SINRG-Lab/AIGlasses/mechanical/README.md

# Mechanical (3D-printed frame)

| Folder | Contents |
|---|---|
| `v3/` | Current parts: right arm, arm cover, hinge system (STL) |
| `hero-renders/` | Exploded view + renders |
| `older/v1`, `older/v2` | Earlier frame revisions (STL/3MF/F3D, presentation) |
| `older/design-1`, `older/design-2`, `older/vision` | Early concept iterations (Mar–May 2026) |

Sliced printer files (`.ufp`, `.bgcode`, `.gcode`) are not kept — slice the STL/3MF for your printer.
