SINRG-Lab/AIGlasses/companion/hardware/pcb/README.md

# PCB

| Path | Contents |
|---|---|
| `schematic/AIglasses.kicad_sch` | KiCad schematic |
| `schematic/Smart_Glasses_V1.pdf` | V1 schematic export |
| `v2-right/gerbers/` | KiCad Gerbers + drill for `Smart_Glasses_V2_PCB_RIGHT` (the right-temple board), plus the JLCPCB upload previews/metadata |
| `v2-right/jlc-production/` | JLCPCB's processed production data for order `12041108A_Y5` (ODB++ and per-layer files) |

No LEFT-board fab files are in the repo.
