SINRG-Lab/AIGlasses/Cad Designs/Older/V1/Presentation1.pptx

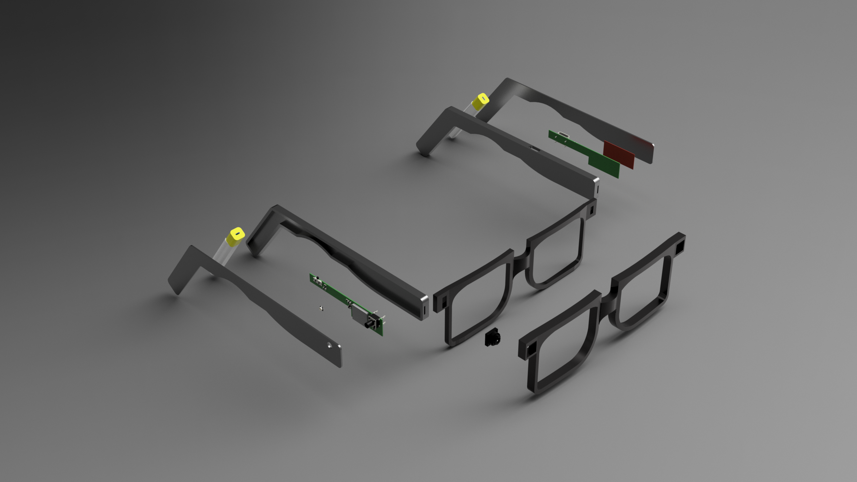
[picture p23: figure]

Right & Left Arms

Batteries

Arm Covers

Custom PCB’S

Antenna

Programmable touchpad

Frame Covers

Camera

Frames
