SINRG-Lab/AIGlasses/Cad Designs/V3/AmrHInges3/Metadata/thumbnail.png

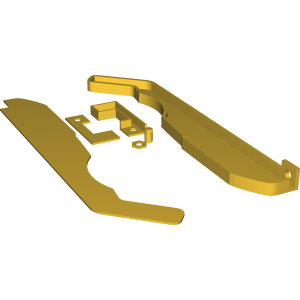
Cad Designs/V3/AmrHInges3/Metadata/thumbnail.png
