SINRG-Lab/AIGlasses/companion/hardware/pcb/v2-right/gerbers/GBR_11290166_1_bottom.png

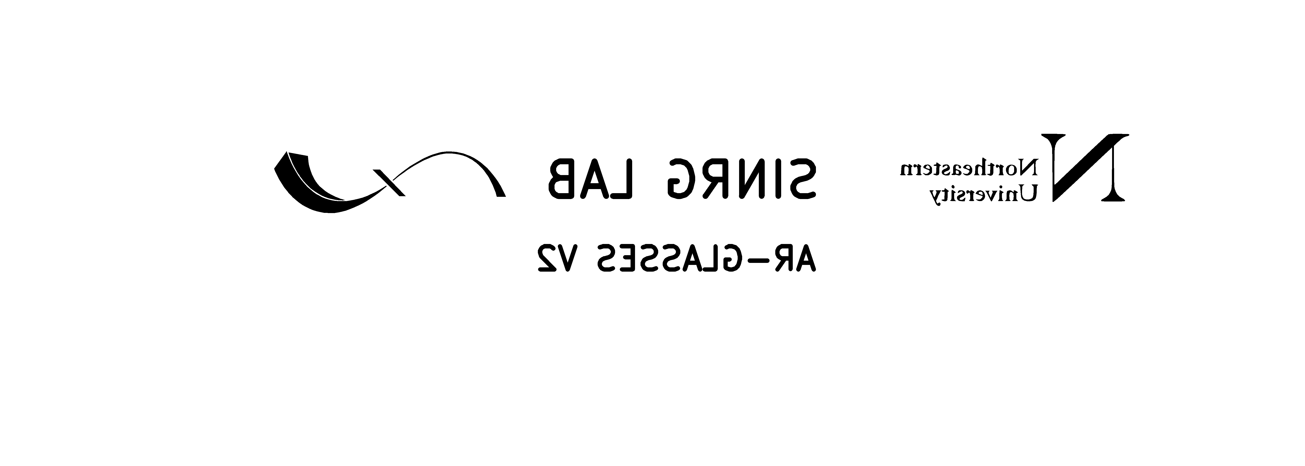
companion/hardware/pcb/v2-right/gerbers/GBR_11290166_1_bottom.png
