SINRG-Lab/AIGlasses/mechanical/hero-renders/Screenshot 2026-05-05 at 3.59.41 PM.png

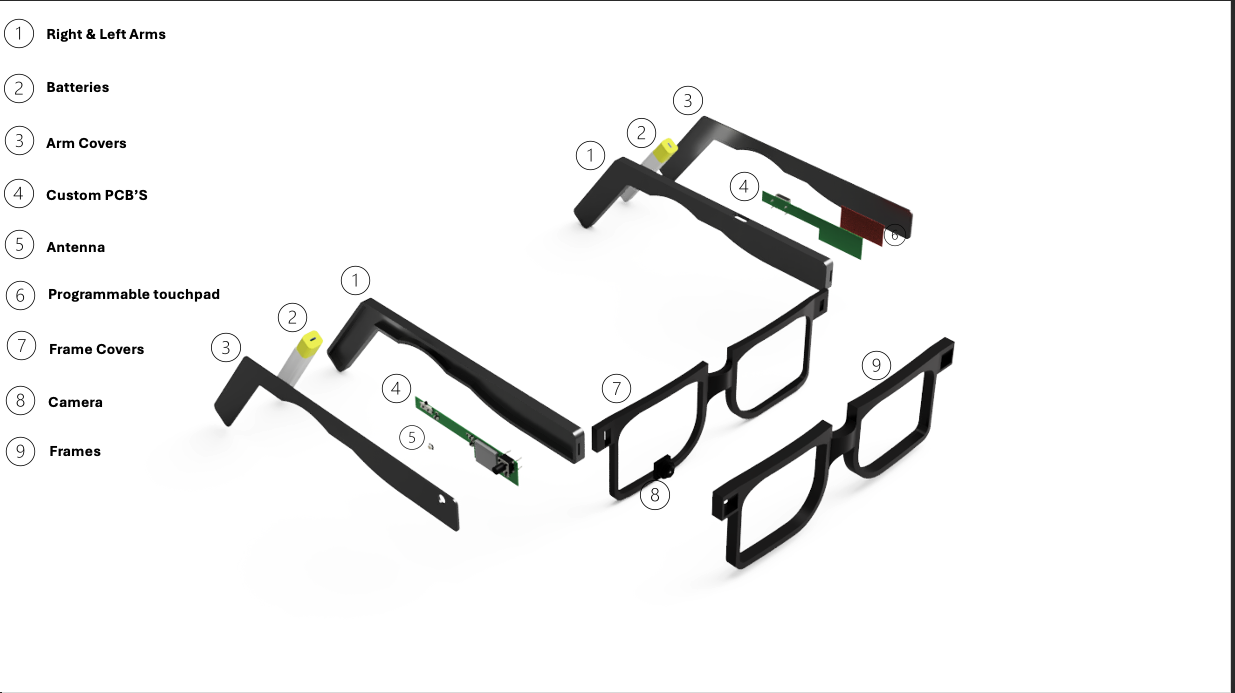
mechanical/hero-renders/Screenshot 2026-05-05 at 3.59.41 PM.png
