SINRG-Lab/AIGlasses/Cad Designs/V3/STL/HingeTop(T).stl

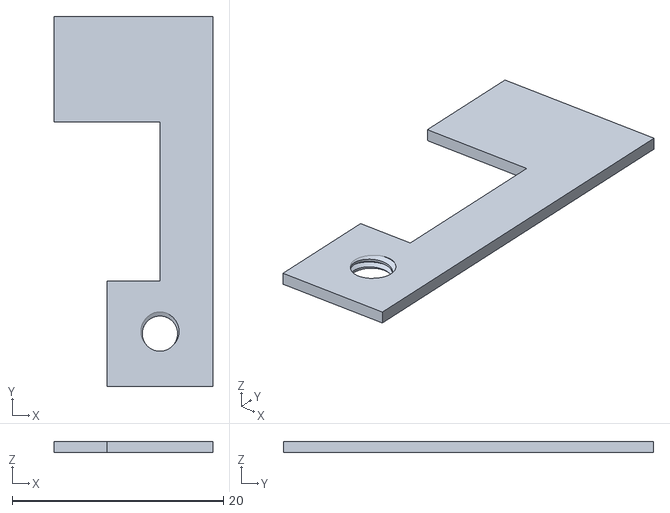
[picture p30: CAD file, 2026-06-15]
Cad Designs/V3/STL/HingeTop(T).stl
15.0 x 35.0 x 1.00
