SINRG-Lab/AIGlasses/mechanical/v3/HIngeTop v2.stl

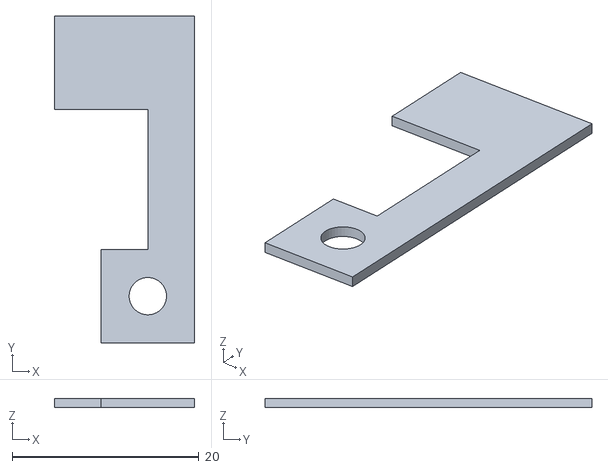
[picture p32: CAD file, 2026-10-23]
mechanical/v3/HIngeTop v2.stl
15.0 x 35.0 x 1.00
