SINRG-Lab/AIGlasses/mechanical/v3/Rod v6.stl

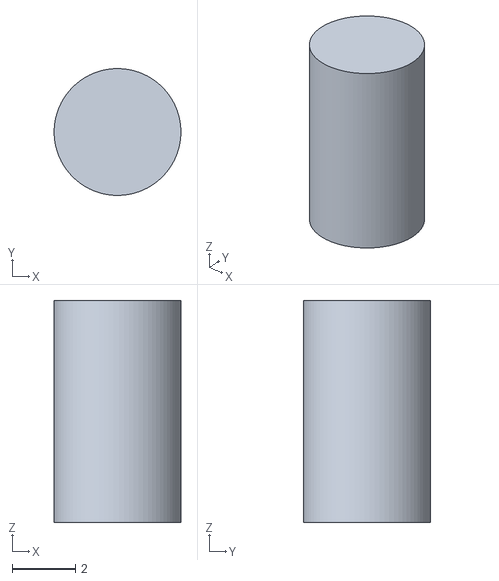
[picture p34: CAD file, 2026-10-23]
mechanical/v3/Rod v6.stl
4.00 x 4.00 x 7.00
