SINRG-Lab/AIGlasses/mechanical/v3/ArmCover.stl

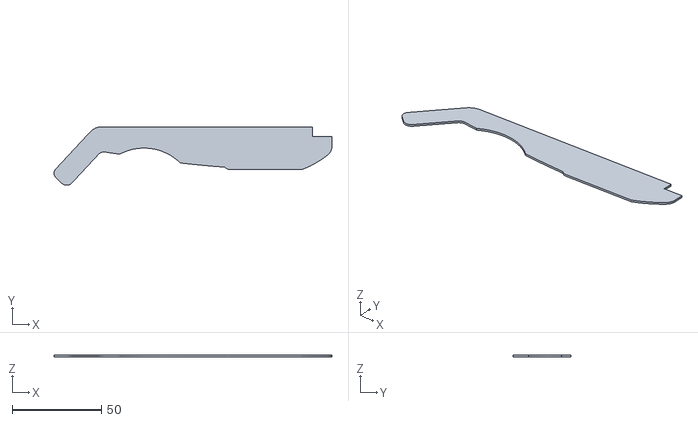
[picture p35: CAD file, 2026-10-23]
mechanical/v3/ArmCover.stl
155.8 x 32.8 x 1.00
