SINRG-Lab/AIGlasses/mechanical/v3/ThreadedRod.stl

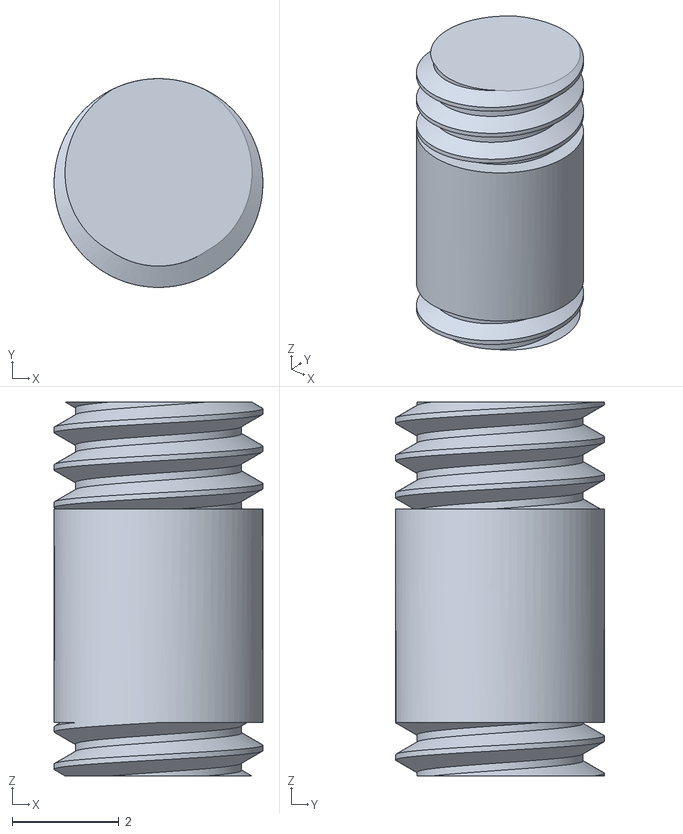
[picture p36: CAD file, 2026-10-23]
mechanical/v3/ThreadedRod.stl
3.91 x 3.91 x 7.00
