SINRG-Lab/AIGlasses/mechanical/v3/Hinge v2.stl

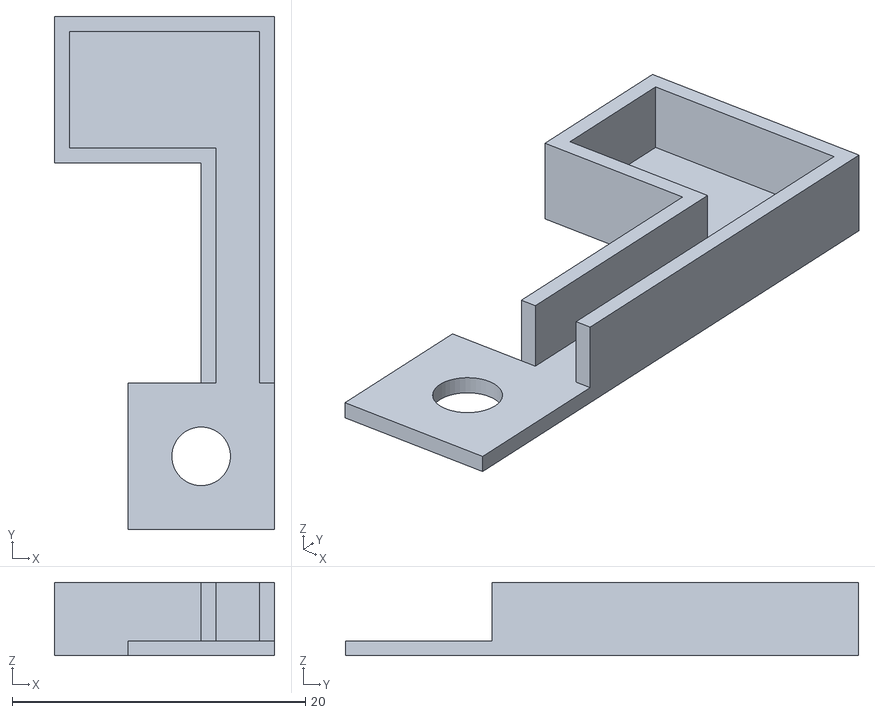
[picture p37: CAD file, 2026-10-23]
mechanical/v3/Hinge v2.stl
15.0 x 35.0 x 5.00
