SINRG-Lab/AIGlasses/mechanical/v3/Nut.stl

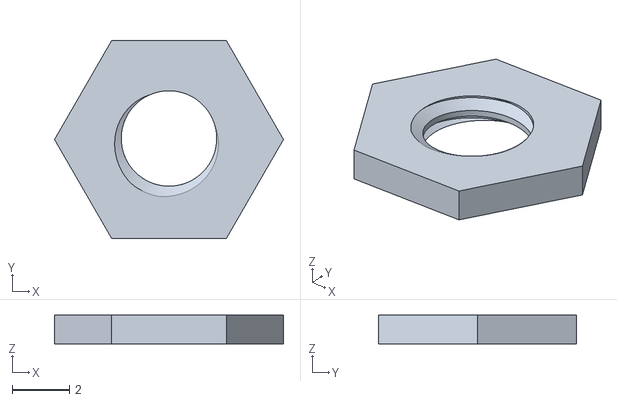
[picture p38: CAD file, 2026-10-23]
mechanical/v3/Nut.stl
8.00 x 6.93 x 1.00
