SINRG-Lab/AIGlasses/Cad Designs/Older/Glasses 3D Design 1/Arm1.stl

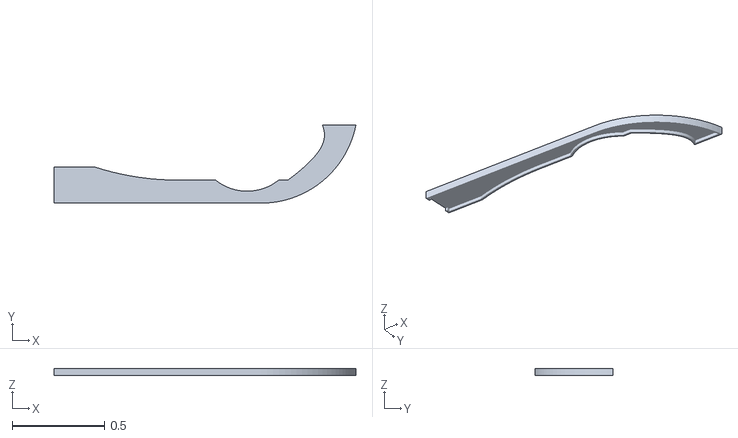
[picture p39: CAD file, 2026-06-15, an earlier design]
Cad Designs/Older/Glasses 3D Design 1/Arm1.stl
1.64 x 0.425 x 0.04
