SINRG-Lab/AIGlasses/Cad Designs/Older/Glasses 3d Design 2/ArmRight2.stl

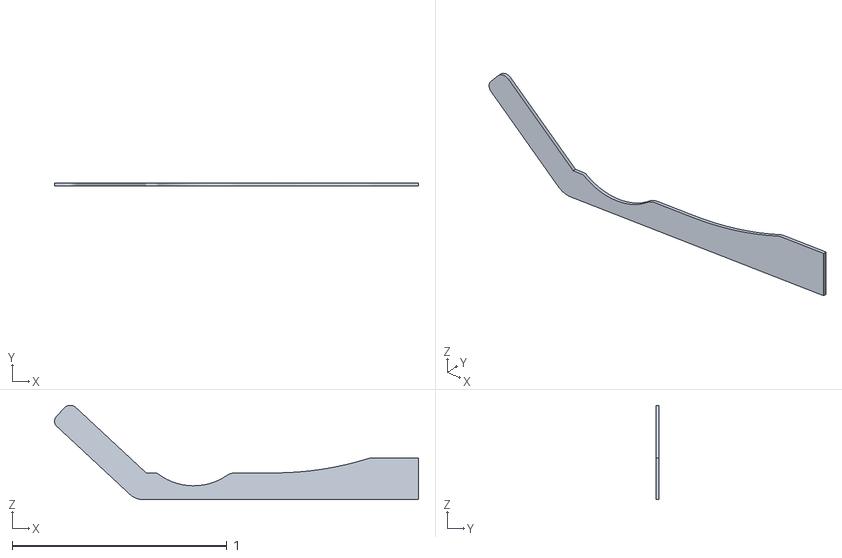
[picture p40: CAD file, 2026-06-15, an earlier design]
Cad Designs/Older/Glasses 3d Design 2/ArmRight2.stl
1.70 x 0.015 x 0.44
