SINRG-Lab/AIGlasses/Cad Designs/Older/V1/RightArm v1.stl

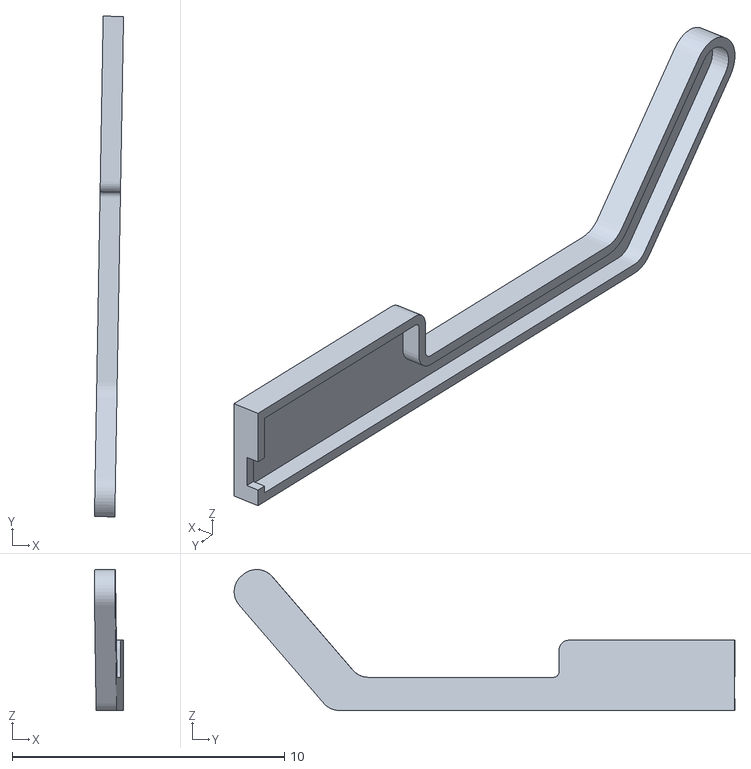
[picture p41: CAD file, 2026-06-15, an earlier design]
Cad Designs/Older/V1/RightArm v1.stl
1.07 x 18.4 x 5.18
