SINRG-Lab/AIGlasses/Cad Designs/Older/V2/STL/LeftCover v1.stl

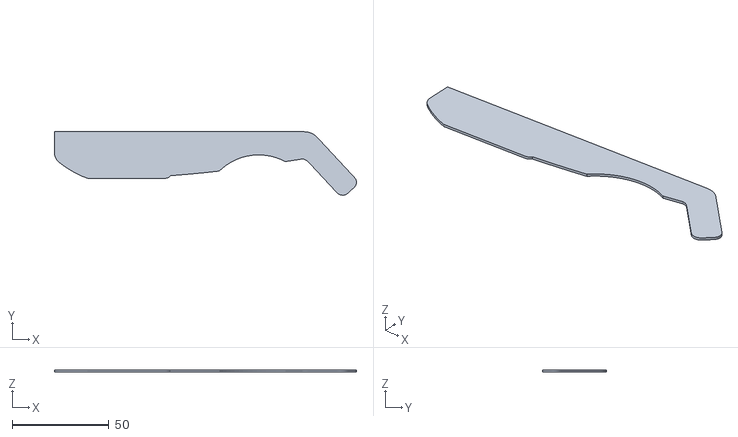
[picture p43: CAD file, 2026-06-15, an earlier design]
Cad Designs/Older/V2/STL/LeftCover v1.stl
155.8 x 32.8 x 1.00
