SINRG-Lab/AIGlasses/mechanical/older/design-2/Glasses.3mf

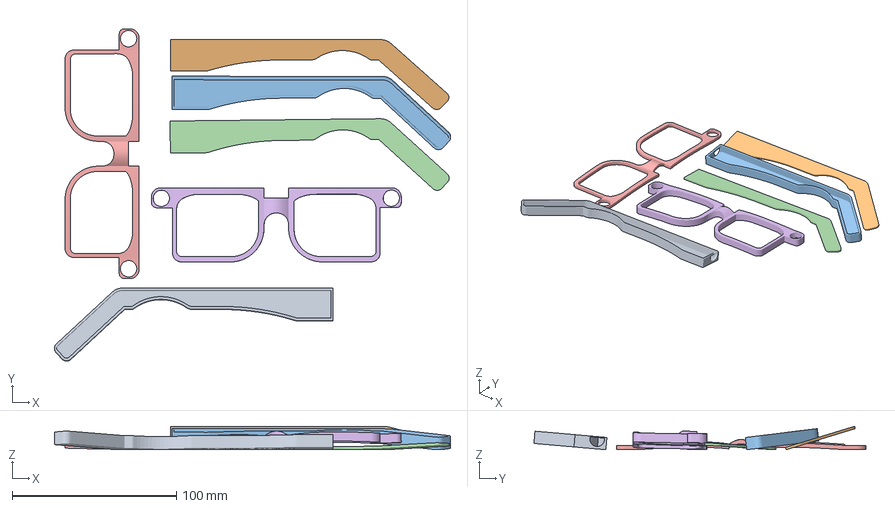
[picture p44: CAD file, 2026-10-23, an earlier design]
mechanical/older/design-2/Glasses.3mf
241.0 x 202.2 x 14.3 mm
ArmLeft1.stl
ArmLeft2.stl
ArmRight1.stl
ArmRight2.stl
Front2.stl
Front.stl
