SINRG-Lab/AIGlasses/mechanical/older/v1/LeftArm v1.stl

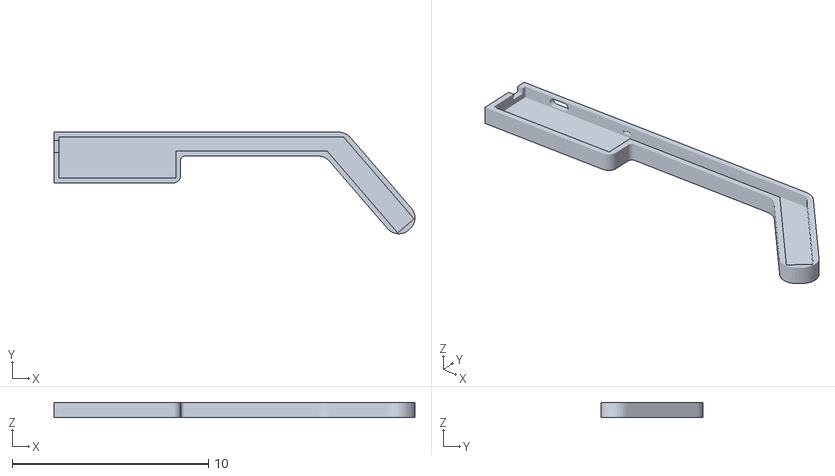
[picture p45: CAD file, 2026-10-23, an earlier design]
mechanical/older/v1/LeftArm v1.stl
18.4 x 5.18 x 0.75
