SINRG-Lab/AIGlasses/mechanical/older/v2/STL/Body1.stl

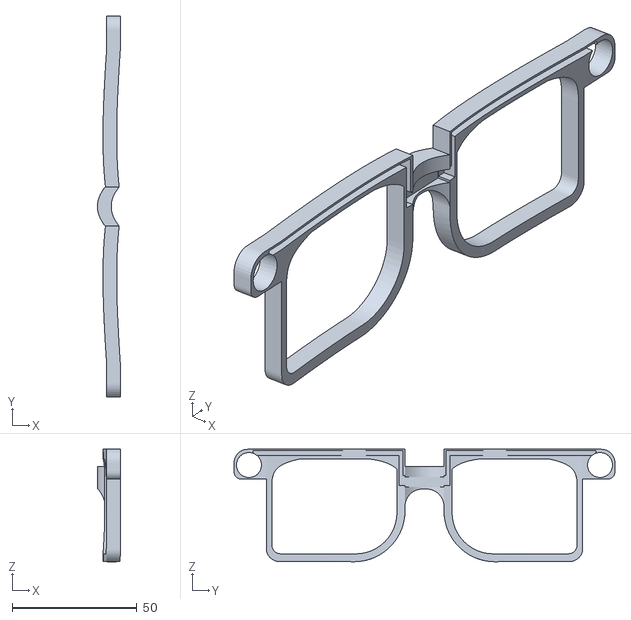
[picture p46: CAD file, 2026-10-23, an earlier design]
mechanical/older/v2/STL/Body1.stl
9.16 x 152.4 x 45.0
