SINRG-Lab/AIGlasses/(list of files, cad)

Other CAD files:
mechanical/older/design-1/arm2.stl
Cad Designs/Older/Glasses 3d Design 2/ArmLeft1.stl
Cad Designs/Older/Glasses 3d Design 2/ArmLeft2.stl
Cad Designs/Older/Glasses 3d Design 2/ArmRight1.stl
Cad Designs/Older/Glasses 3d Design 2/Front2.stl
Cad Designs/Older/V1/ArmCovers_CoverLeft v1.stl
Cad Designs/Older/V1/ArmCovers_CoverRight v1.stl
Cad Designs/Older/V1/Component3.f3d
Cad Designs/Older/V2/STL/FrameCover.stl
Cad Designs/Older/V2/STL/RightArm Cover v4.stl
Cad Designs/Older/V2/STL/RightArm.stl
mechanical/older/design-1/Frame1.stl
mechanical/older/design-2/Front.stl
mechanical/older/v1/ArmCovers_CoverLeft v1.3mf
mechanical/older/v1/ArmCovers_CoverRight v1.3mf
mechanical/older/v1/FrameCover v1.stl
mechanical/older/v1/FrameCover.f3d
mechanical/older/v1/FrontFrames v2.stl
