SINRG-Lab/AIGlasses/Preformance Tests/S3/Data Points.docx

## 1. Device & Hardware Configuration

Component | Configuration
MCU | ESP32-S3 @ 240 MHz
PCB | C6 PCB
Transport | BLE (WRITE_NR) + Streaming Ring Buffer
PSRAM | 8192 KB
Free PSRAM (idle) | ~8189 KB
Camera | OV3660
PTT Button | GPIO5

## 2. GPIO & Interface Mapping

Function | Pins / Interface
Speaker (I2S) | BCLK=GPIO6, LRC=GPIO7, DIN=GPIO8
Microphone | Built-in PDM (CLK=GPIO42, DATA=GPIO41)
Camera XCLK | GPIO10
PTT Button | GPIO5

## 3. Audio Configuration

### Microphone

Parameter | Value
Type | Built-in PDM (MSM261D3526H1CPM)
Sample Rate | 16,000 Hz
Bit Depth | 16-bit
Channels | Mono
DMA Chunk Size | 512 samples (32 ms)

### Speaker

Parameter | Value
Interface | I2S STD
Sample Rate | 22,050 Hz
Bit Depth | 16-bit
Channels | Stereo (L=R, dual-amp)
Codec / Amp | MAX98357A

## 4. Buffering & Streaming Parameters

Item | Value
Ring Buffer Size | 160 KB
Max Audio Stored | ~3.72 s @ 22050 Hz mono
Pre-buffer Threshold | 24,000 bytes (~544 ms)
Streaming Underruns | 0%

## 5. BLE Configuration & Throughput

Parameter | Value
MTU | 512 bytes
Audio Payload / Packet | 507 bytes
Packets per Audio Reply | 256
BLE RX Throughput (ESP32) | ~39 KB/s
BLE TX Throughput (Android – Voice) | ~48.7 KB/s
BLE TX Throughput (Android – Vision) | ~50 KB/s

## 6. Memory Usage (ESP32-S3)

Stage | Free Heap | Free PSRAM
After Boot | ~297 KB | ~8189 KB
After Mic Init | ~271 KB | ~7994 KB
After BLE Init | ~208 KB | ~7994 KB
After Playback | ~189 KB | ~7994 KB
Min Ever Heap | ~190 KB | —

## 7. Voice-Only Pipeline Latency Breakdown

Stage | Duration
Whisper (STT) | 8,582 ms
GPT Response | 2,417 ms
TTS API | 2,954 ms
MP3 Decode | 694 ms
Pipeline Total | 14,663 ms (14.7 s)
BLE TX (Android → Glasses) | 2,591 ms

## 8. Vision Pipeline Latency Breakdown (Photo + Voice)

Stage | Duration
Whisper (Vision) | 1,224 ms
Vision API | 2,453 ms
TTS API (Vision) | 4,352 ms
MP3 Decode (Vision) | 3,553 ms
Pipeline Total (Vision) | 11,599 ms (11.6 s)
BLE TX (Vision) | 13,551 ms

## 9. Image Transfer Performance (Vision Mode)

Metric | Value
Image Size | ~7.6 KB
Image RX Time | 282 ms
Image Throughput | ~27 KB/s

## 10. End-to-End Audio Playback Metrics (ESP32)

Metric | Value
Playback Start Delay | ~551 ms
Total Audio Received | 129,124 bytes
Dropped Packets | 0
Lost Packets | 0
Round-Trip (PTT release → playback end) | ~18.18 s

### Want next steps?

Metric | Derived
Whisper (voice) | 16:02:01.072 − 16:01:52.490 = 8,582 ms
GPT | 16:02:03.489 − 16:02:01.072 = 2,417 ms
TTS API | 16:02:06.443 − 16:02:03.489 = 2,954 ms
MP3 decode | 16:02:07.149 − 16:02:06.455 = 694 ms
Pipeline total | 16:02:07.149 − 16:01:52.486 = 14,663 ms
BLE TX (Android) | 16:02:09.743 − 16:02:07.152 = 2,591 ms → 48.7 KB/s
Whisper (vision) | 16:05:32.533 − 16:05:31.311 = 1,224 ms
Vision API | 16:05:34.986 − 16:05:32.533 = 2,453 ms
TTS API (vision) | 16:05:39.339 − 16:05:34.987 = 4,352 ms
MP3 decode (vision) | 16:05:42.903 − 16:05:39.350 = 3,553 ms
Pipeline total (vision) | 16:05:42.908 − 16:05:31.309 = 11,599 ms
BLE TX (vision) | 16:05:56.459 − 16:05:42.908 = 13,551 ms → 50 KB/s
Image RX (Android) | 16:05:26.176 − 16:05:25.894 = 282 ms → 27 KB/s
