SINRG-Lab/AIGlasses/HardwareTest/sim_photo.jpg

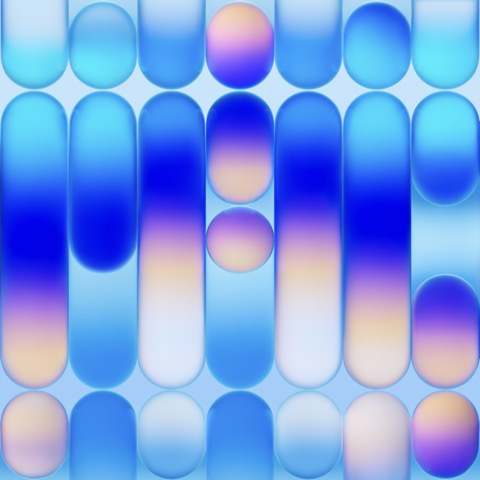
HardwareTest/sim_photo.jpg
