SINRG-Lab/AIGlasses/HardwareTest/seq_debug.csv

t | seq | size
526434.7490 | 0 | 509
526434.7514 | 1 | 7
526434.8391 | 2 | 509
526434.8407 | 3 | 7
526434.9588 | 4 | 509
526434.9605 | 5 | 7
526434.9889 | 6 | 509
526434.9903 | 7 | 7
526434.9923 | 8 | 509
526434.9934 | 9 | 7
526435.1111 | 10 | 509
526435.1130 | 11 | 7
526435.1131 | 13 | 7
526435.1713 | 16 | 509
526435.2286 | 19 | 7
526435.2295 | 23 | 7
526435.2610 | 24 | 509
526435.2629 | 25 | 7
526435.2659 | 26 | 509
526435.2885 | 27 | 7
526435.3188 | 28 | 509
526435.3238 | 32 | 509
526435.3269 | 33 | 7
526435.3522 | 36 | 509
526435.3788 | 39 | 7
526435.3795 | 41 | 7
526435.4111 | 42 | 509
526435.4129 | 43 | 7
526435.4387 | 44 | 509
526435.4403 | 45 | 7
526435.4422 | 46 | 509
526435.4432 | 47 | 7
526435.5024 | 48 | 509
526435.5041 | 49 | 7
526435.5058 | 50 | 509
526435.5285 | 51 | 7
526435.5324 | 52 | 509
526435.5339 | 53 | 7
526435.5585 | 54 | 509
526435.5601 | 55 | 7
526435.5912 | 56 | 509
526435.5927 | 57 | 7
526447.3213 | 58 | 509
526447.3231 | 59 | 7
526447.4101 | 60 | 509
526447.4118 | 61 | 7
526447.4134 | 62 | 509
526447.4385 | 63 | 7
526447.4412 | 64 | 509
526447.4425 | 65 | 7
526447.5058 | 66 | 509
526447.5074 | 67 | 7
526447.6492 | 68 | 509
526447.6507 | 69 | 7
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
