SINRG-Lab/AIGlasses/mechanical/hero-renders/ExplodedView.pdf

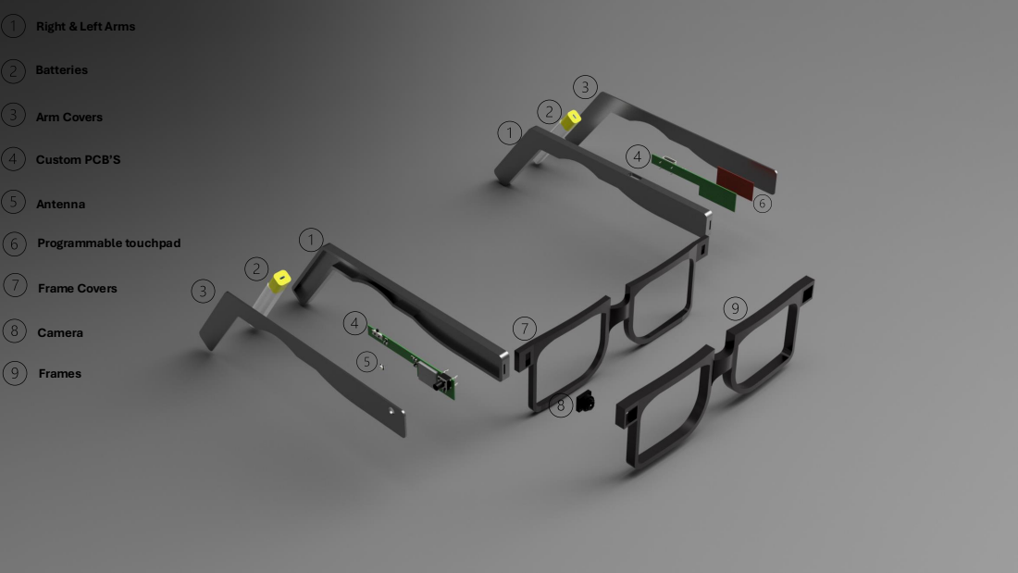
[picture p53: page 1]
Batteries; Arm Covers; Custom PCB’S; Antenna; Programmable touchpad; Frame Covers; Camera; Frames

Right & Left Arms
