SINRG-Lab/AIGlasses/companion/hardware/pcb/schematic/Smart_Glasses_V1.pdf

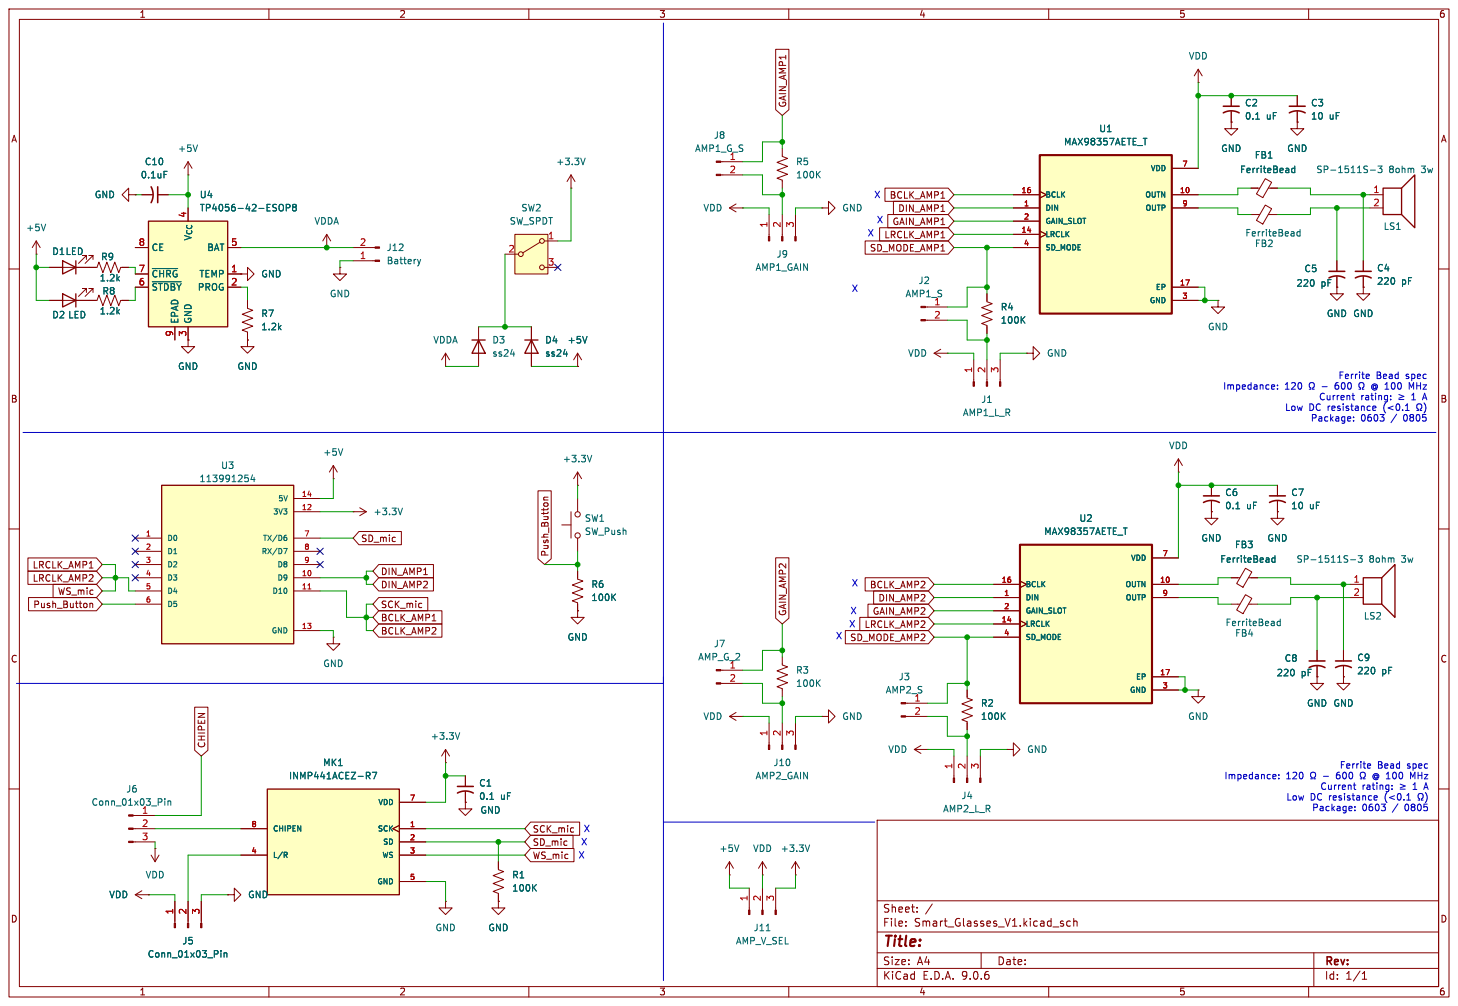
[picture p54: page 1]

3 BAT 5 TEMP 1 PROG 2 GND GND

Id: 1/1 Title: File: Smart_Glasses_V1.kicad_sch Sheet: /
