SINRG-Lab/AIGlasses/mechanical/older/v1/Presentation1.pdf

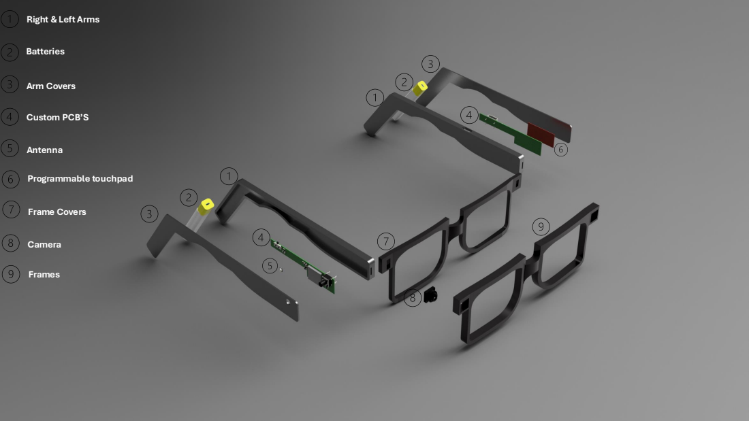
[picture p55: page 1]
Batteries; Arm Covers; Custom PCB’S; Antenna; Programmable touchpad; Frame Covers; Camera; Frames

Right & Left Arms
