SINRG-Lab/AIGlasses/Cad Designs/Older/Glasses Vision/Presentation1.pdf

Batteries; Arm Covers; Custom PCB’S; Antenna; Programmable touchpad; Frame Covers; Camera; Frames

Right & Left Arms
