SINRG-Lab/AIGlasses/(commit log)

2025-11-05 Implemented namespace to communicate with OpenAI via websockets instead of WebRTC. Untested on board but builds fine. Also still having issues reading in the wav file.
2026-01-30 Added existing code from Walter-Board. Currently encounters errors parsing through audio data.
2026-02-04 Helper file to programatically soft reset the device before running other programs.
2026-02-04 Moved files off of board to add to repo.
2026-02-06 Achieved first successful text to audio query of Gemini on the Walter Board.
2026-02-10 Fix OpenAI Chat API: correct endpoint, model, request format, and response parsing
    The chat() function had 4 bugs preventing ChatGPT responses:
    - Wrong endpoint (/v1/responses → /v1/chat/completions)
    - Invalid model name (gpt-4.1-mini → gpt-4o-mini)
    - Wrong request field (input → messages)
    - Wrong response parsing (output_text → choices[0].message.content)
2026-02-12 Migrated firmware to PlatformIO with modular architecture
    - Converted both ESP32-C6 projects to PlatformIO
    - Refactored monolithic code into reusable modules:
    * I2SManager: Hardware abstraction for I2S (shared)
    * AudioManager: Audio buffering and playback (shared)
    * BLEManager: Bluetooth LE communication
    * NetworkManager: WiFi + WebSocket communication
    - Centralized configuration in config.h
    - Optimized build flags for ESP32-C6
    - Updated to NimBLE-Arduino v2.3.7 for ESP32-C6 support
    - Added comprehensive documentation
    - Main app reduced from 470 lines to 180 lines
    - Code reuse: I2S and Audio modules shared between projects
2026-02-17 Migrated firmware to PlatformIO
    Replaced modular architecture with direct .ino-to-src/main.cpp approach.
    Both projects build cleanly using the pioarduino ESP32-C6 platform.
2026-02-17 Fix Arduino IDE duplicate definition error
    Added .development marker to src/ folders so Arduino IDE ignores
    them and only compiles the .ino files, while PlatformIO uses src/main.cpp.
2026-02-17 Fix Arduino IDE and PlatformIO coexistence
    Use src_dir in platformio.ini to point directly at the .ino sketch folders.
    No duplicate src/main.cpp needed — Arduino IDE and PlatformIO both compile
    the same single source file without conflicts.
2026-02-17 Add PTT button debug output every 200ms
    Prints [BTN] 0 or [BTN] 1 to serial every 200ms so button
    state can be verified without needing a BLE connection.
2026-02-17 Remove PTT button debug output
2026-02-17 Fix INMP441 mic channel — use right slot for L/R=GND
    INMP441 with L/R pin tied to GND outputs audio data in the right
    I2S slot, not the left. Using ONLY_LEFT was reading silence, causing
    Whisper to transcribe nothing as "you". Switched to ONLY_RIGHT.
2026-02-25 Improve audio quality: larger DMA buffers, APLL clock, and sinc resampler
    ESP32 firmware:
    - Enable APLL (use_apll=true) for jitter-free I2S clock on speaker
    - Increase DMA buffers from 8×512 to 16×1024 (~743ms headroom) to
    eliminate buffer-underrun buzzing/clicks
    Android pipeline:
    - Fix stereoToMono integer overflow (widen Short to Int before averaging)
    - Replace linear interpolation resampler with windowed-sinc (Hann window,
    16-tap half-width) to remove aliasing buzz when downsampling from
    24000Hz → 22050Hz
2026-02-25 Add dual-speaker support via I2S true-stereo interleaving
    - Switch speaker I2S from ONLY_LEFT to RIGHT_LEFT (true stereo) so both
    I2S slots are driven on every frame
    - AMP1 (LR/GAIN=GND) reads left slot, AMP2 (LR/GAIN=3.3V) reads right slot
    - playSpeaker() now expands mono PCM into interleaved L=R stereo chunks
    before i2s_write(), giving both amps the same audio signal
    - Add stereoChunk[STEREO_CHUNK_MONO*2] static buffer for the expansion
2026-03-18 Fix idle speaker buzz and add missing TTS speak() method
    - Drive AMP_DIN LOW in mic mode to silence MAX98357A when I2S bus
    is in RX mode (floating DIN caused buzzing from shared BCLK/WS)
    - Add OpenAI TTS speak() method to OpenAIService.kt (was missing,
    caused "Unresolved reference" build error)
    - Add playback debug diagnostics (DC offset, sample range, DMA writes)
2026-03-20 BLE optimization: WRITE_NR, anti-buzz measures, and packet loss tracking
    - Switch BLE audio RX from WRITE to WRITE_NR for max throughput
    - Force AMP_DIN LOW before I2S teardown to prevent floating pin buzz
    - Disable APLL (C6 buzzes at 22050Hz with it)
    - Add fade-out on last 50ms of audio to avoid abrupt cutoff pop
    - Flush 8 silence chunks + i2s_stop() for clean DMA drain
    - Add BLE sequence number tracking to detect WRITE_NR packet loss
    - Buffer overflow: play truncated audio instead of dropping silently
    - Even-align BLE payload size to prevent 16-bit sample misalignment
    - Reset playAudio flag on Start marker to prevent stale overflow state
2026-04-07 Fix vision mode ordering: ESP32 sends image before audio END marker
2026-04-07 Add ESP32-S3 firmware with camera + vision mode
2026-04-07 Re-encode camera image as PNG for OpenAI vision API compatibility
2026-04-07 Remove unused files: root .idea, kicad schematic, C6Imp, servert.py
2026-04-13 Fix camera capture: add sensor warm-up and retry logic
    esp_camera_fb_get() returns NULL until AEC/AWB loops converge
    after clock start (~500ms). Added 5 warm-up frame discards in
    initCamera() and up to 5 retries with 150ms delays in captureSnapshot().
2026-04-13 Move camera init before mic/PSRAM to fix DMA channel conflicts
    esp_camera_fb_get() returned NULL on every attempt because the PDM
    mic (I2S_NUM_0) and 160KB ring buffer were initialized first, claiming
    DMA channels and fragmenting PSRAM before the camera driver could
    allocate its frame buffers. Moving camera init to run first in setup()
    gives it clean access to DMA and contiguous PSRAM. Added PSRAM
    diagnostics to serial output for debugging.
2026-04-22 Fix S3 speaker GPIO pins to match PCB design, disable camera
    - Update I2S_BCLK, I2S_WS, AMP_DIN to GPIO18/22/20 (matching C6 PCB layout)
    - Disable camera init: GPIO18 (CAM_Y4) conflicts with speaker BCLK on this PCB rev
    - Camera will be re-enabled after next PCB revision resolves the pin conflict
2026-04-22 Change S3 PTT button to active high
2026-04-22 Update S3 speaker/PTT pins to match new PCB footprint, re-enable camera
    Speaker now on BCLK=GPIO9, WS=GPIO5, DIN=GPIO8; PTT moved to GPIO6.
    GPIO18 freed for camera D2, so camera init is restored.
2026-04-27 Fix S3 speech cut-outs and low volume
    - SPK_VOL_SHIFT 2→1: doubles speaker output (-12dB → -6dB)
    - STREAM_START_THRESHOLD 24000→35000: pre-buffer ~800ms to absorb BLE jitter
    - Underrun wait 60ms→120ms: more time to recover before inserting silence
2026-05-18 Fix degraded image quality in gallery thumbnails and full-screen viewer
    Reduce thumbnail inSampleSize from 4 to 2 for sharper grid tiles, and add
    FilterQuality.High to the full-screen Image composable to eliminate upscale blur.
2026-05-18 Load thumbnails at full resolution with high-quality filtering
2026-05-18 Add delete button to thumbnails and fix viewer buttons hidden by status bar
2026-05-18 Lower viewer action buttons further below status bar
2026-06-04 Add [PERF-Mxx] performance instrumentation for S3 test session
    Mirrors the previous C6 and S3 test methodology with tagged log lines
    filterable via grep or adb logcat. Adds new camera and microphone
    diagnostic metrics to investigate known inconsistency issues.
    Firmware (S3_App_imp.ino):
    M1 Mic BLE TX: bytes, chunks, throughput (ESP32 -> Android)
    M4 TTS BLE RX start with heap snapshot
    M5 Ring buffer fill % at playback start
    M6 'S' marker -> first I2S write latency
    M7 Button press -> playback start (end-to-end round-trip)
    M8 Speaker I2S init duration
    M10 BLE RX throughput (Android -> ESP32)
    M11 Utterance: bytes, duration, chunk count
    M13 Heap + PSRAM at boot / camera /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
2026-06-04 Fix camera capture inconsistency and image reassembly failures
    Two distinct bugs behind the "camera sometimes doesn't take / doesn't
    reassemble" symptom:
    1. Capture (firmware S3_App_imp.ino):
    - captureSnapshot() return value was ignored in loop(); a failed
    capture left visionMode=true with a null JPEG, so the glasses sent
    audio with no image silently. Now falls back to voice-only + logs.
    - Added a stale-frame flush (grab+discard, then grab) before capture
    so CAMERA_GRAB_LATEST + fb_count=2 can't return an old idle frame.
    2. Reassembly (firmware + Android):
    - pImageTxChar->notify() return was ignored; NimBLE drops the packet
    silently (BLE_HS_ENOMEM) when the TX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
2026-06-04 Decouple photo capture from question; fix blank images
    Validated on hardware: captures every time, images look correct, image
    reassembly clean (retries=0 dropped=0, no corrupt transfers).
    Gesture rework:
    - Quick double-tap = standalone photo: captured on 2nd press, sent
    without an audio END marker. App stores it, always saves to gallery,
    and opens a 5s window.
    - Single press + hold = voice question; app auto-attaches a photo taken
    within the last 5s (VISION_WINDOW_MS), else voice-only.
    - Double-tap + hold = photo + question bundled (kept as a shortcut).
    - Triple-tap + hold = video (unchanged).
    Blank-image fix:
    - Warm up the sensor (discard 4 frames w/ 20ms spacing) so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
2026-06-04 Fix mic mis-transcription: kill clipping, normalize, upgrade STT
    Validated on hardware: 5 questions in a row transcribed correctly.
    Root cause was the firmware mic gain clipping loud/normal speech
    (peak=32768 → distortion → Whisper hallucinating confident nonsense
    like "this is the best sport in the world").
    - MIC_GAIN 10 → 1. Raw mic is already 16-bit so gain=1 cannot clip;
    all leveling moved to the Android side. (10x and 4x both clipped.)
    - Fixed stale startup banner: "Running on C6 PCB" → "XIAO ESP32-S3".
    App:
    - VoiceAssistantPipeline: normalizeForAsr() peak-normalizes each
    utterance to ~22000 (cap 12x, silence guard) before Whisper, so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
2026-06-09 Add video support to gallery; enable vision feature by default
    - SavedImage gains isVideo flag to distinguish videos from images
    - Gallery shows separate image/video counts, extracts first-frame thumbnails
    for videos via MediaMetadataRetriever, and overlays a play badge
    - ImageViewer adds a Play Video button that opens the system video player
    via FileProvider intent; delete dialog title adapts to media type
    - File size label upgrades from KB-only to MB when file exceeds 1 MB
    - FileProvider registered in AndroidManifest with file_paths.xml exposing
    the gallery/ directory for secure URI sharing
    - Vision feature enabled by default; removed BLE-disconnect lock on vision
2026-06-10 Remove performance-test instrumentation; switch video to triple-tap
    Strip all [PERF-Mxx] markers and [MIC] amplitude debug logging that were
    added for the S3 performance test session — the perf state variables,
    per-frame/per-chunk timing, throughput logs, and heap/PSRAM boot prints.
    Functional logging ([STREAM], [BLE], [PTT], [CAM], [SYS]) and the
    underrun-detection logic are retained.
    Also change the video gesture from quick single-tap to quick triple-tap
    to start (single tap still stops), so single/double taps no longer
    trigger recording by accident.
    Remove obsolete C6_App_imp/ sketch and Doccumentation/ folder.
2026-06-11 Add S3_App_V2 modular firmware; fix gesture hold debounce and update Android app
    Replaces the monolithic S3_App_imp with a 7-module firmware (audio_io, ble_link,
    camera_ctl, gestures, playback, ring_buffer, status_led). Key fixes over V1:
    - Gesture: defer GESTURE_PRESS_VOICE/VISION to 350 ms hold confirmation so quick
    taps no longer send spurious 'S' start markers that clear the audio buffer and
    cut off the first ~250 ms of the real utterance
    - BLE: notifyWithRetry on all send paths; static packet buffer replaces VLA
    - Playback: PSRAM ring buffer, 70 KB pre-buffer, 4 s stall watchdog, barge-in
    - Mic: DMA flush before each recording to drop stale pre-roll
    - Camera: deferred photo send so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
2026-06-15 Clean up repo: add CAD, docs, PCB; drop old C6 firmware
2026-07-08 Add realtime voice (GPT Realtime), µ-law BLE, iOS app, bench rig
    Firmware (S3_App_V2):
    - Realtime voice mode ('M'/'m' opt-in): G.711 µ-law audio both directions,
    halving BLE packet rate (centrals drop notifications above ~40/s). Fully
    backward compatible — no 'M' = exact V2 PCM16 behavior.
    - In-band image framing on IMAGE_TX ('H'/'I'/'J'), 2M PHY + Data Length
    Extension, even BLE_MAX_PAYLOAD (drops can't byte-shift PCM), PDM clock at
    2.048 MHz (in-spec mode), restored [PERF-M] instrumentation.
    Android app: GPT Realtime engine (RealtimeVoiceClient + AudioCodec µ-law),
    settings toggle with legacy pipeline as fallback, live voice-state UI.
    STT model → gpt-4o-mini-transcribe-2025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
2026-07-08 Add project docs: mic root-cause, roadmap, Friday build plan, parts/wiring
2026-07-09 Live video streaming to iOS + fix image-header drop race
    Photo bug: firmware sent the image 'H' header and first fragment in the same
    BLE connection event; the header lost the race, so the app orphaned every
    fragment ("no open transfer"). Fixes:
    - Firmware: pace the header into its own connection event (like fragments).
    - iOS + Android apps: recover a dropped header from a seq-0 fragment.
    Live video (iOS): motion-JPEG frames from the glasses (triple-tap to start,
    tap to stop) now render live in a new Live View tab instead of being
    discarded — accumulate video fragments, emit completed frames, ~fps meter,
    dropped frames skipped silently.
2026-07-09 Live video: QQVGA low-latency mode for ~12 fps, drop corrupt frames
    Choppiness/wrong-colors were fragment-count limited: a QVGA frame is ~12 BLE
    notifications, capping ~5 fps, and any lost fragment garbles the frame.
    - Firmware: video switches the sensor to QQVGA (160x120) + high JPEG
    compression during a session (~4-5 fragments/frame), restores full-quality
    QVGA for photos. Tighter 7 ms fragment pacing for the video burst.
    - iOS: drop video frames that lost any fragment (seqGaps > 0) — they decode
    with wrong colors — rather than flashing garbage; show only clean frames.
2026-07-09 Hands-free vision: tap-then-hold photo straight into GPT Realtime
    The tap-then-hold gesture (existing GESTURE_PRESS_VISION) now works end-to-end
    with realtime voice: capture a photo, inject it into the live conversation,
    and the voice spoken during the hold is the question — no phone tap needed.
    - Firmware: in realtime mode the vision photo is sent up front (flags 0x02)
    at the start of the hold, so it lands in the conversation before the
    question turn closes; legacy pipeline path unchanged.
    - iOS: header flag 0x02 routes the photo to onVisionPhoto → attachImage into
    the realtime session + save to gallery; standalone photos unchanged.
    TODO: mirror the flag-0x02 handling in the And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
2026-08-04 Fix untethered boot/mic stalls: never block on USB-CDC prints with no host
    On a power-only USB-C supply (or battery) nothing enumerates the USB port,
    so with CDC-on-boot each Serial print blocks up to the CDC TX timeout once
    the buffer fills — slow boot and stalled mic streaming. TX timeout 0 drops
    log bytes instantly when no computer is attached; logging is unchanged when
    one is.
2026-08-04 iOS: run in the background — BLE keeps the glasses working with the app closed
    - bluetooth-central UIBackgroundModes (partial Info.plist merged into the
    generated one): glasses BLE traffic wakes the app in the background and
    voice/photos keep flowing with the phone in a pocket
    - CBCentralManager restore identifier + willRestoreState: iOS relaunches the
    app after termination and hands the live connection back
    - Scene-phase handling: on background, close the WiFi bulk lane deliberately
    (TCP cannot survive suspension) and pause redials — photos ride Bluetooth;
    on foreground, re-bootstrap WiFi if wanted and nudge the voice websocket
    - Ping liveness cleared across suspend/resume so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
2026-08-05 Background voice actually works + Dynamic Island live activity
    Background upgrades (the "mic turns off in background" fix):
    - Mic audio arriving over BLE now REVIVES a dead websocket on the spot —
    iOS kills the socket during suspension and the reconnect backoff timer
    freezes with the app, so button presses streamed into a closed session;
    the wake now cancels the frozen backoff, reconnects immediately, and the
    first words queue inside URLSession until the handshake completes
    - Background-task assertion held during voice exchanges (~30 s continuous
    runtime per round trip instead of just BLE wake slices), auto-released
    15 s after the last audio
    Dynamic Island / Lock Screen:
    - New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
2026-08-06 Glasses simulator: test the phone apps end-to-end with no ESP32
    Mac impersonates the firmware over BLE (bless peripheral): µ-law mic
    streaming of real synthesized speech, TTS sink decoded + played on the Mac,
    'P' ping echo, byte-exact 74 B 'T' stats packets, in-band photo transfer.
    Commands: t=talk, p=photo, v=vision. WiFi 'F' ignored by default;
    --wifi-n fakes credentials to exercise the app's join-failure path.
    (sim_question.wav is gitignored — regenerate per the file header.)
2026-08-06 Android app: Transport V2 parity, WiFi auto-join, foreground service, GUI refresh
    Transport (new com.example.aiglasses.link package):
    - LinkManager facade + BleLinkClient (refactor of BleVoiceService): BLE-primary
    policy, µ-law realtime voice, 'P' pings w/ RTT + wedged-link recovery, full
    74-byte 'T' stats parse, in-band H/I/J images w/ seq-0 header recovery,
    auto-reconnect state machine under Android scan-throttle limits
    - WifiLinkClient: WifiNetworkSpecifier local-only auto-join (the Android
    answer to Wi-Fi Direct — ESP32 can't speak real P2P) via network.socketFactory,
    framed TCP protocol, 'R' hello, keepalive, redial 8x3s + slow retry 30s
    Voice + background:
    - RealtimeVoice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
2026-08-06 Sim fix: create characteristics value-less — CoreBluetooth requires cached initial values to be read-only, writable/notify chars must be nil
2026-08-06 Android UI: "Quiet Instrument" redesign + sim-discoverable scanning
    Scan fix: filter list now also matches device names AIGlasses-SIM /
    AIGlasses-ESP32S3 — macOS CoreBluetooth peripherals advertise 128-bit
    service UUIDs in an Apple-only overflow area Android scanners can't see,
    so the bench simulator was invisible to the service-UUID filter.
    Redesign (spec: .context/quiet_instrument_spec.md — Nothing X / Meta AI /
    Google Home '25 / M3 Expressive / Teenage Engineering synthesis):
    - Dark-only instrument theme: near-black Ink canvas, hairline borders,
    zero elevation, one signal-orange accent, monospace telemetry, M3E
    spring/tween motion system
    - Home: line-drawn glasses glyph hero + 8d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
2026-10-23 Reorganize repo into companion/ and standalone/
    Layout
    - companion/: firmware/S3_App_V2, android (was AIglasses), ios (was
    iOSGlasses), bench-rig/HardwareTest, hardware/pcb, docs, archive
    - standalone/: arduino (ryder-arduino branch), micropython-prototype
    (ryder branch), both with history preserved
    - mechanical/: CAD frames (was "Cad Designs"), shared
    - Root README explains the two designs; older companion firmware
    generations are git tags (companion/c6-wifi-server, c6-ble, s3-v1,
    s3-v2-ble)
    Removed
    - 9 inaccurate/filler docs: FRIDAY_BUILD_PLAN, and C6-era
    COMPILATION_FIXES, PCM_VISUALIZATION_GUIDE, PLATFORMIO_GUIDE,
    PLATFORMIO_SETUP_COMPLETE, QUICK_START, QUICK_START_MODULAR,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
